zl2avf/si5351-sampling-detector/zl2avf-sd-pcb.jpg

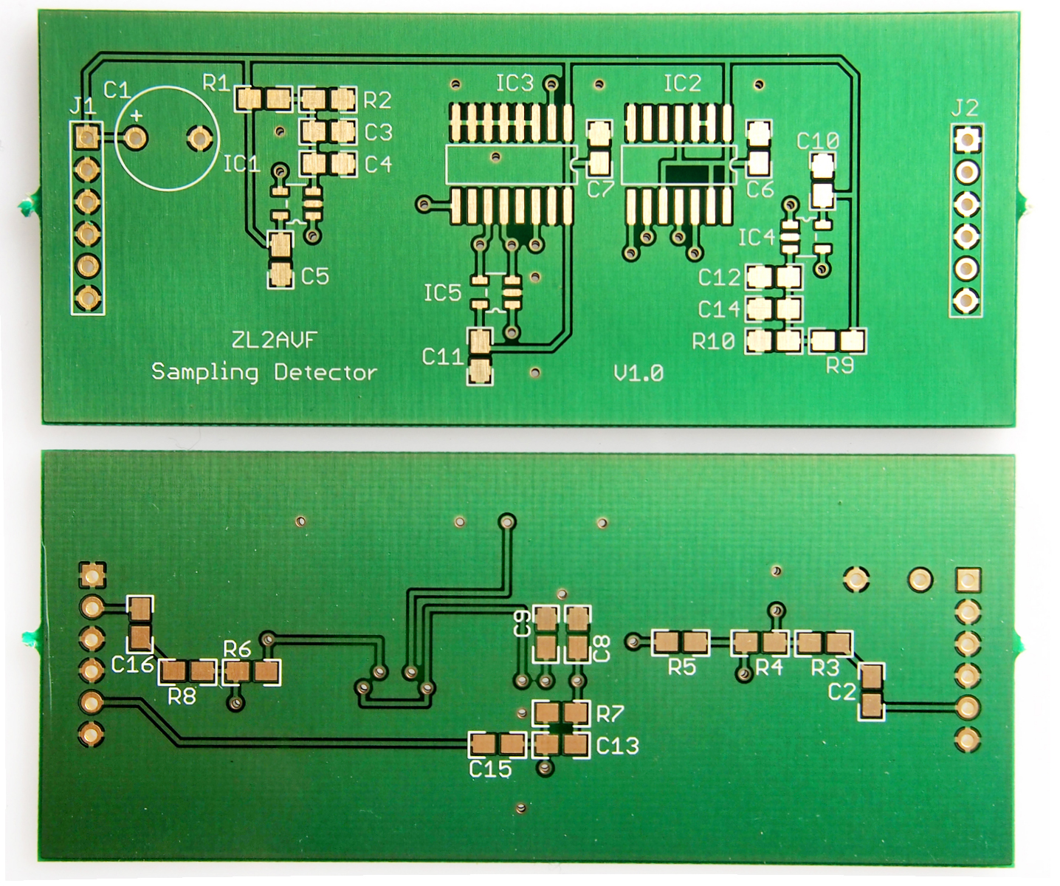
zl2avf-sd-pcb.jpg
