zl2avf/si5351-sampling-detector/si5351-sampling-detector-circuit.jpg

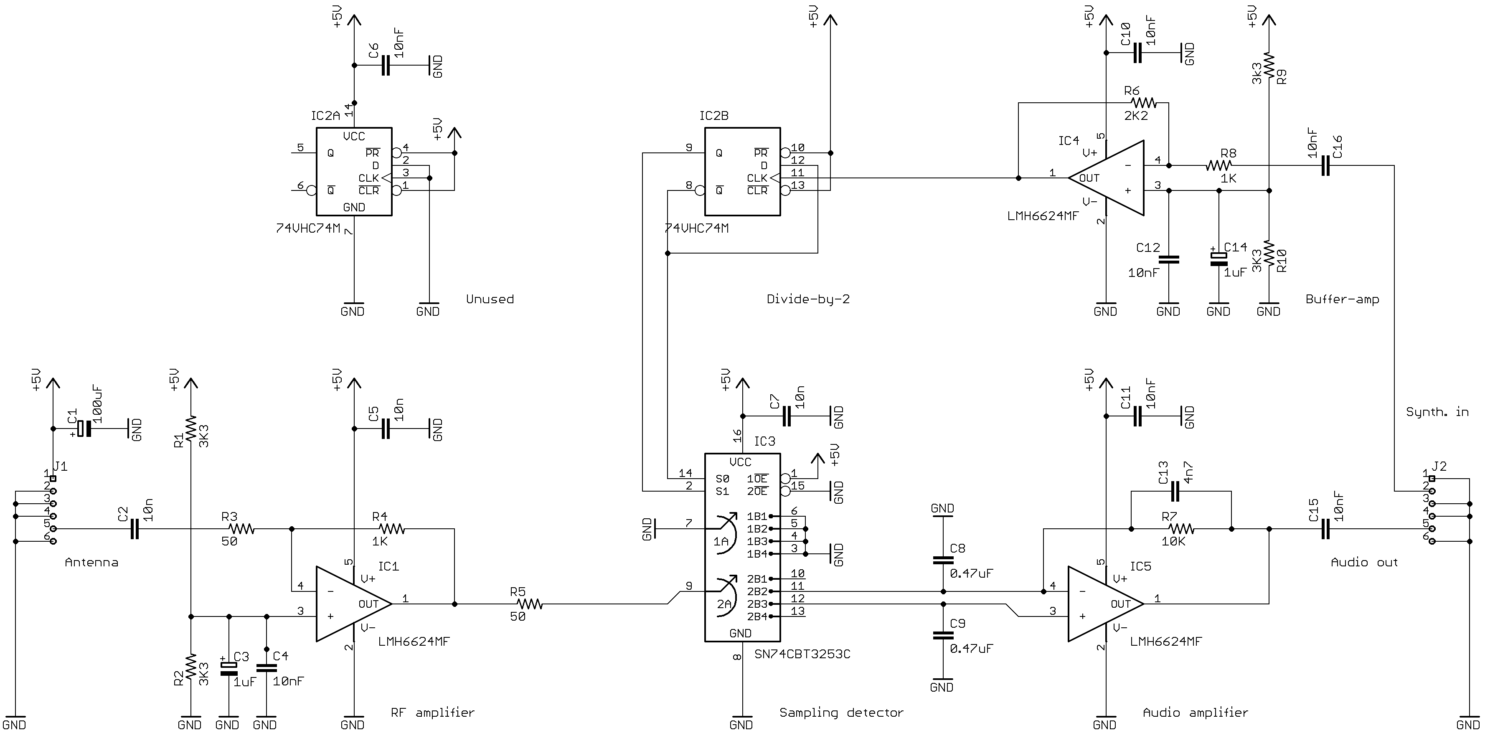
si5351-sampling-detector-circuit.jpg
