zl2avf/si5351-sampling-detector/(commit log)

2015-08-19 gerber pcb files
    complete set of gerber files for duplicating my pcb
2015-09-15 Audio sample
    This audio-clip demonstrates the audio quality from this simple circuit.
    The antenna was a one metre length of wire. The frequency was 7.167 MHz
